Colorful0913/Bing/05、xx（仅供参考）/重要说明.jpg

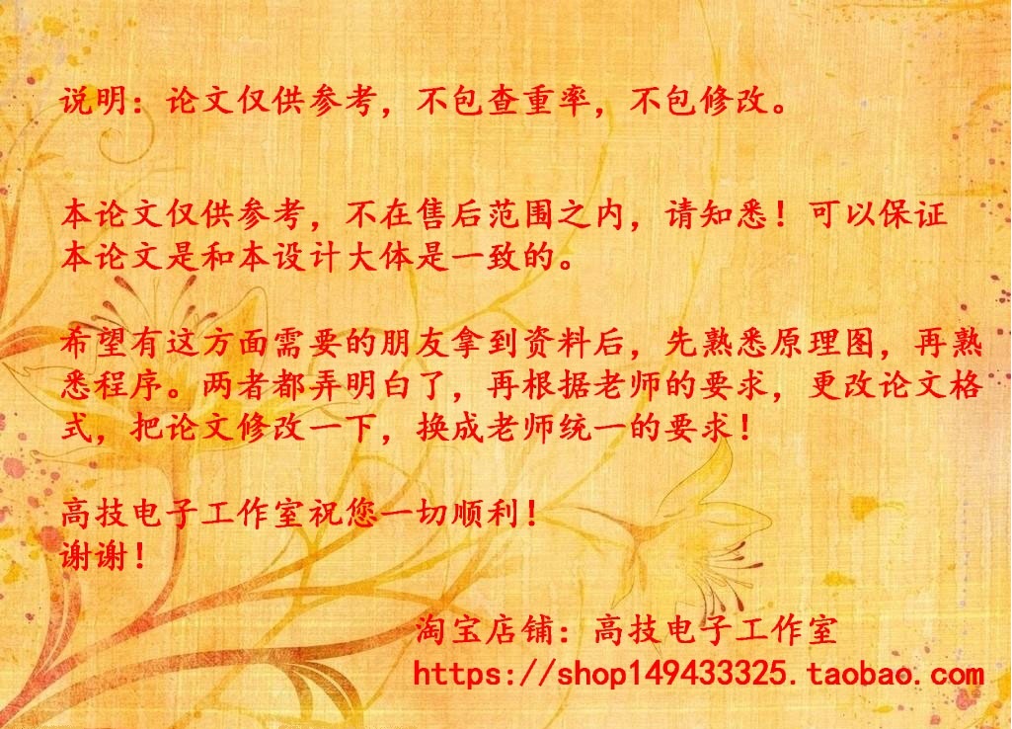
05、xx（仅供参考）/重要说明.jpg
