Colorful0913/Bing/15、软件--AltiumDesigner 安装包/下载链接.docx

AD21

链接：https://pan.baidu.com/s/1PjZRpn5fyLb_b4fBxMVxTA

提取码：bwog

内有安装步骤
