Colorful0913/Bing/16、软件--Keil 安装包/Keil4 for c51.docx

Keil4 for c51

链接：https://pan.baidu.com/s/1aW2NqCbxQEBSRBnlR4P-bA

提取码：244b

安装步骤：https://blog.csdn.net/weixin_45488504/article/details/126841689
