Colorful0913/Bing/17、软件--Proteus 安装包/Proteus软件.docx

任选其一：

Proteus8.13

链接：https://pan.baidu.com/s/1NiYXPCH6za3L4XKlXG91vw

提取码：8x27

Proteus8.3

链接：https://pan.baidu.com/s/18M6kN65PtYBDRmnJfNIrVw

提取码：h10p
