Colorful0913/Bing/09、数据手册/25、软件--Keil 安装包/Keil软件安装包与安装教程.docx

Keil软件安装包与安装教程下载链接与密码：

链接：http://pan.baidu.com/s/1pKXQDT5 密码：wyun

买设计，就到--高技电子工作室。授人以鱼，也要授之以渔！

https://shop149433325.taobao.com

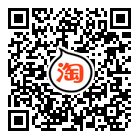
[picture p3: figure]
