Colorful0913/Bing/04、仿真图/1、打开仿真程序需要安装哪个软件.jpg

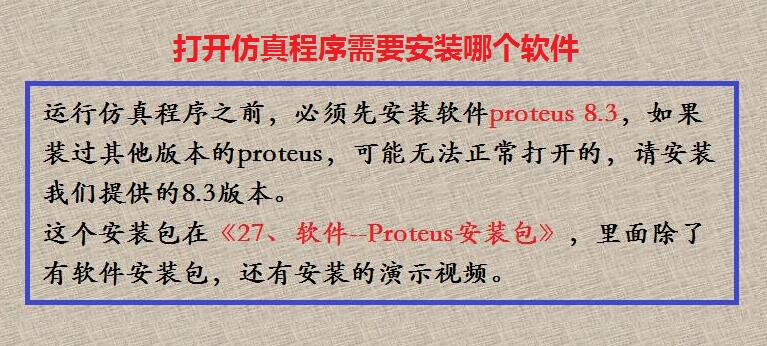
04、仿真图/1、打开仿真程序需要安装哪个软件.jpg
