Colorful0913/Bing/11、实物高清图片/4.jpg

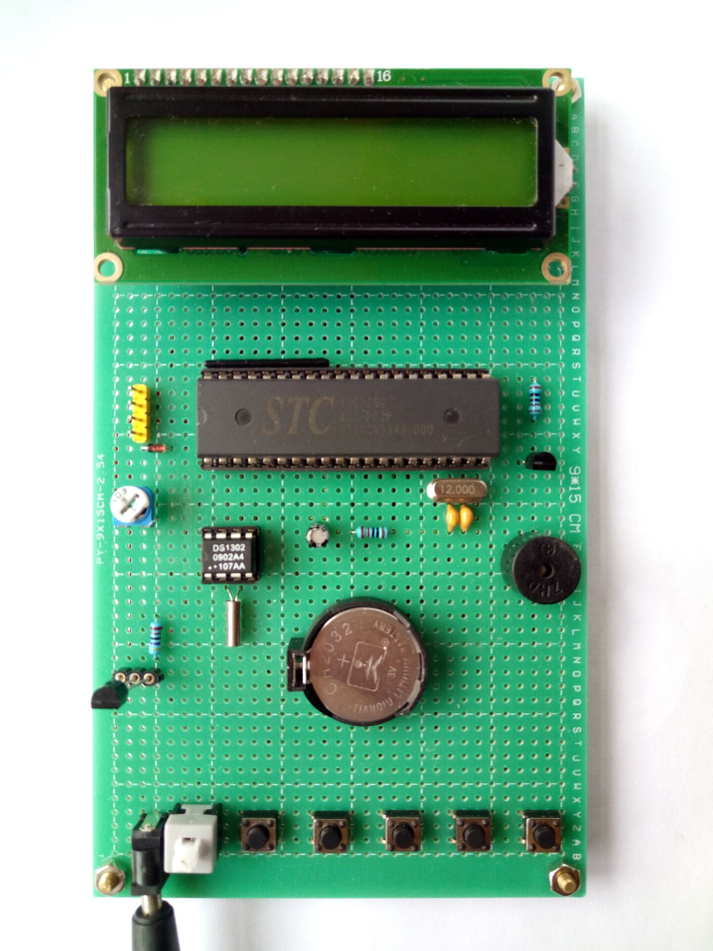
11、实物高清图片/4.jpg
