Colorful0913/Bing/12、焊接参考图片/5.jpg

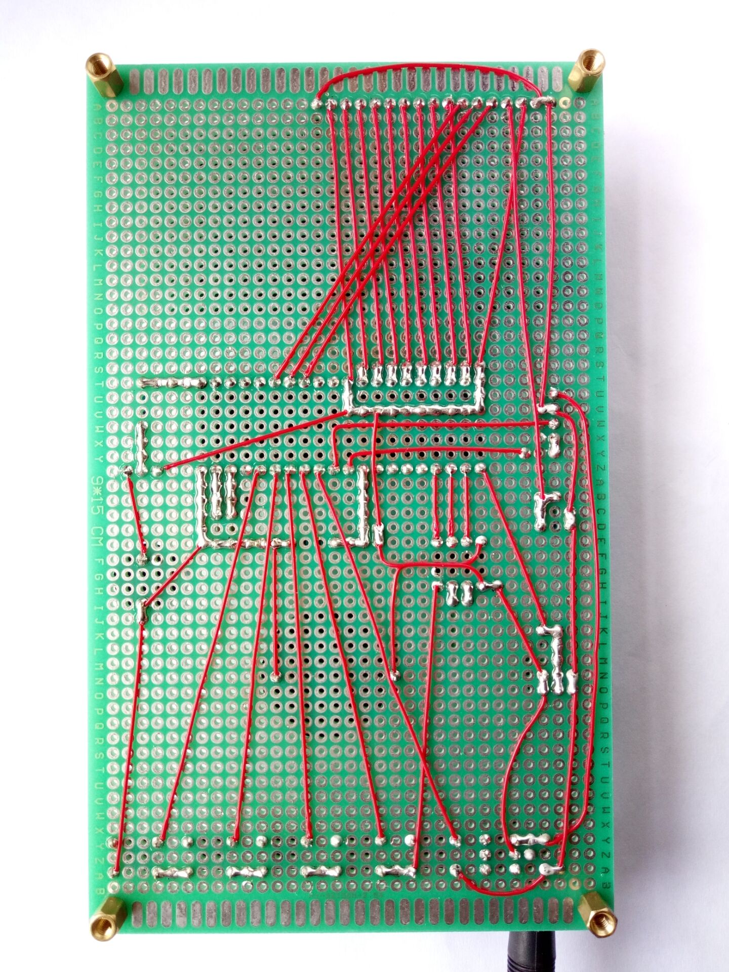
12、焊接参考图片/5.jpg
