Colorful0913/Bing/(list of files, cad)

Other CAD files:
03、单片机程序/02、程序（Keil版）/main.OBJ
