Colorful0913/Bing/02、电路图（原理图和PCB图）/02、PDF与Word格式/PCB.pdf

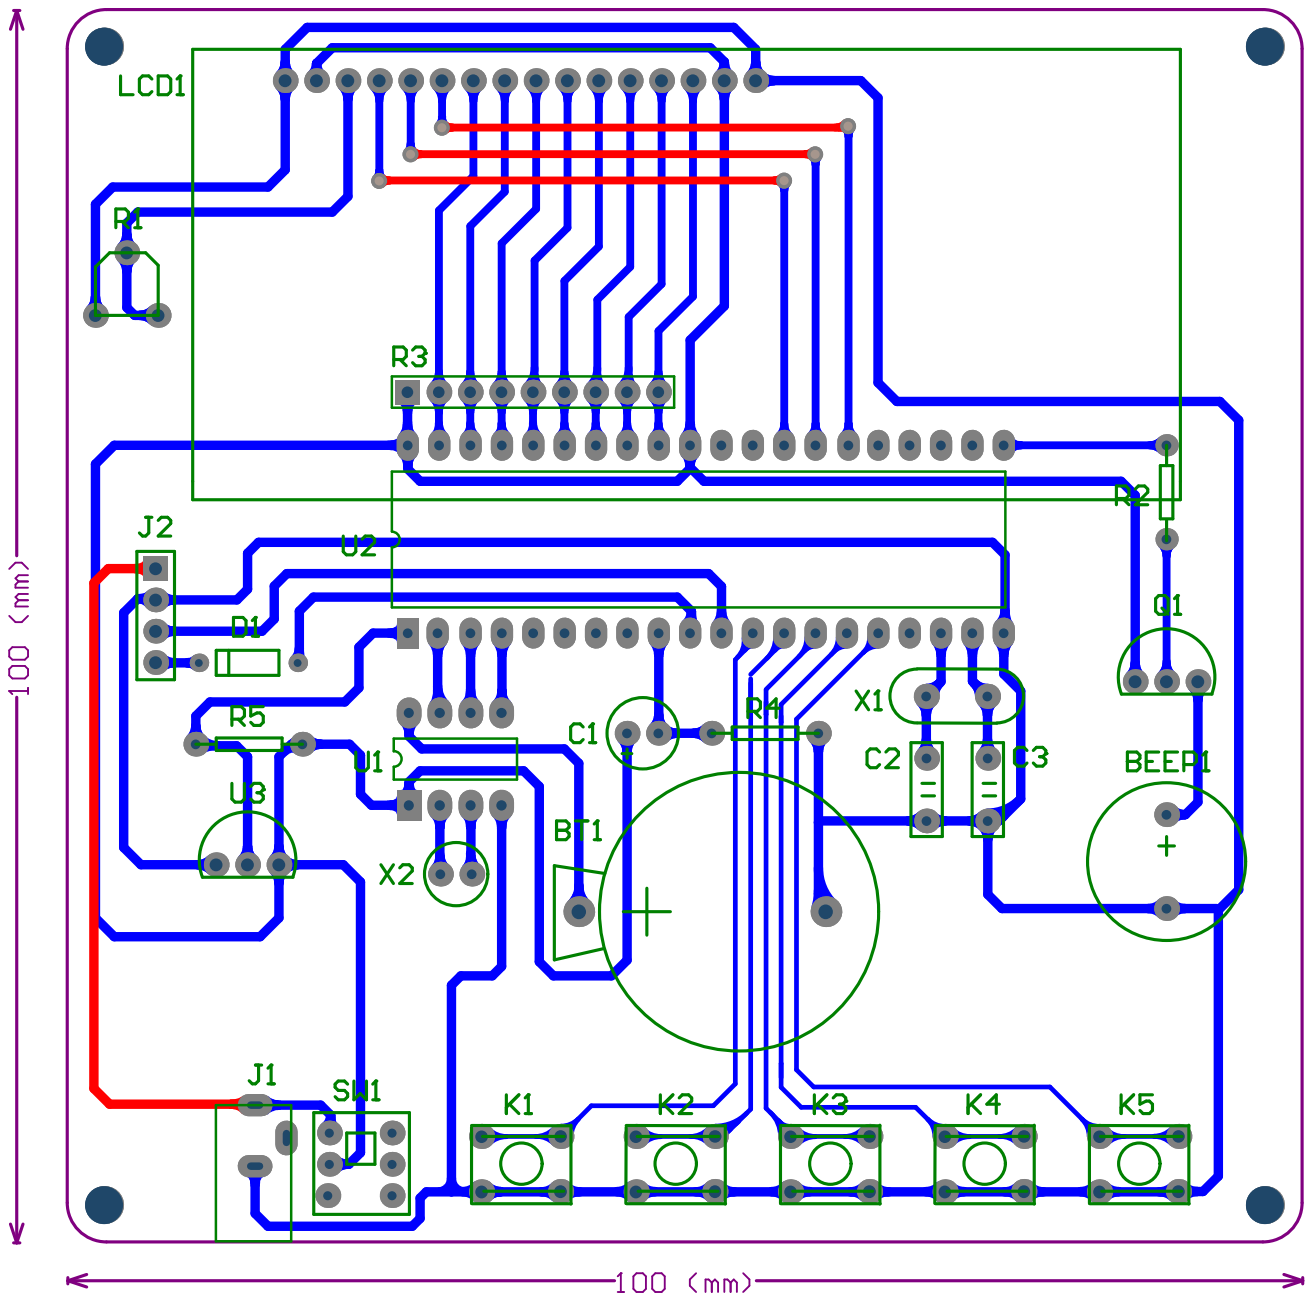
[picture p25: page 1]
