Colorful0913/Bing/02、电路图（原理图和PCB图）/02、PDF与Word格式/SCH.pdf

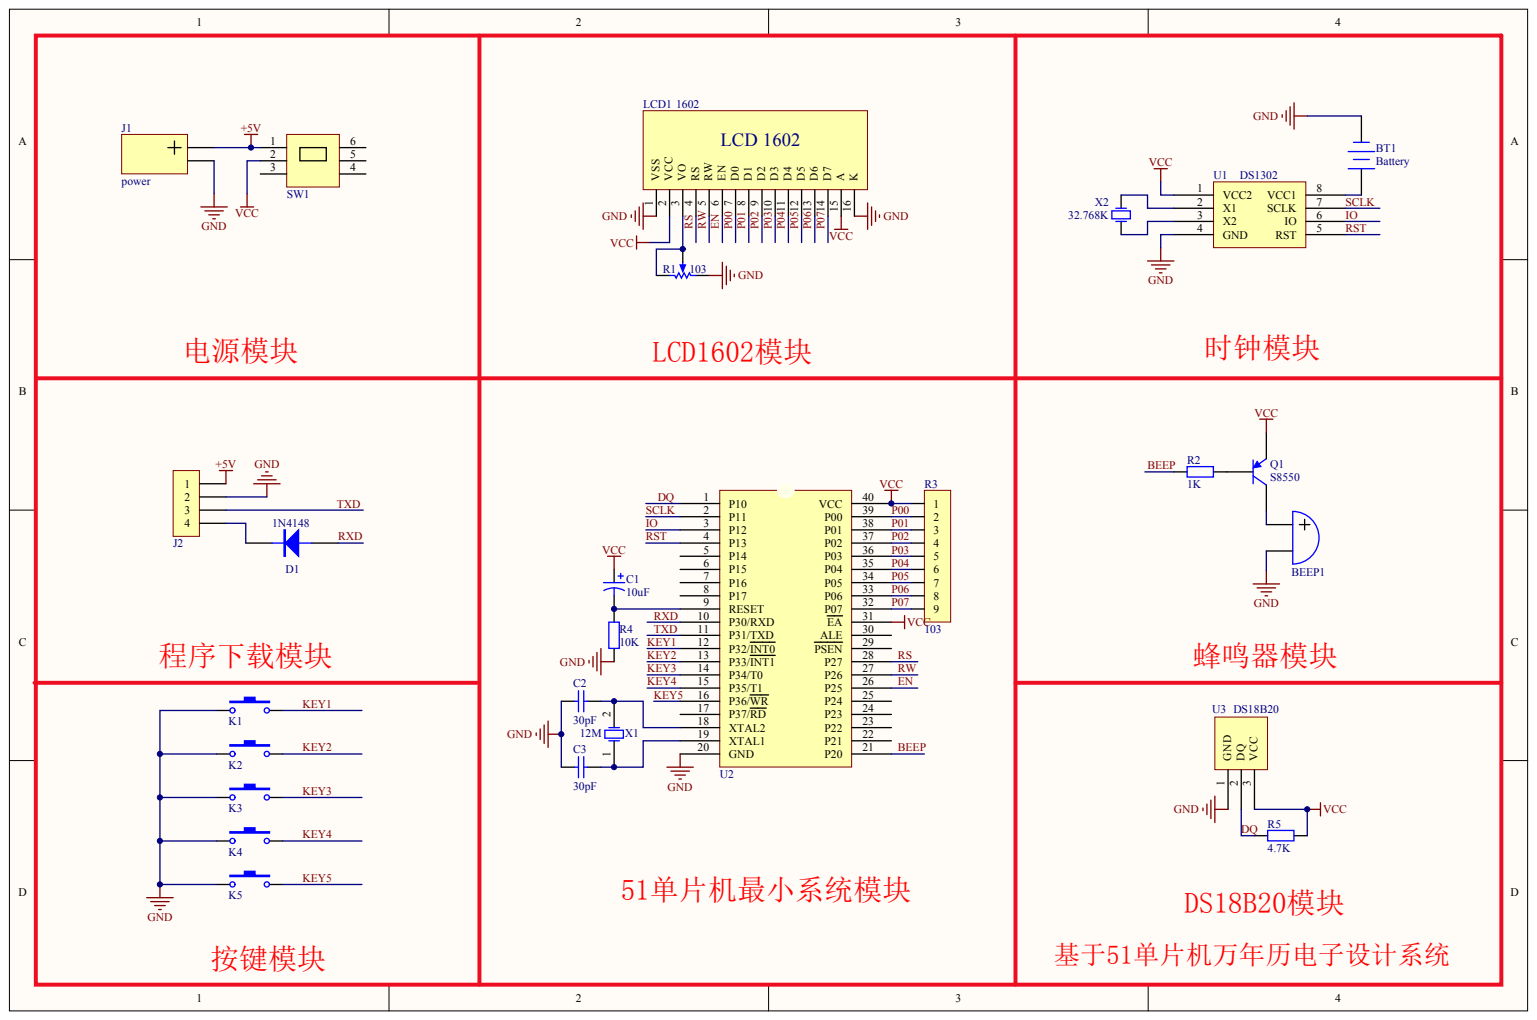
[picture p26: page 1]
