Colorful0913/Bing/(list of files, drawings)

Other design files:
02、电路图（原理图和PCB图）/01、Altium Designer格式/基于51单片机万年历电子设计系统.PcbDoc
02、电路图（原理图和PCB图）/01、Altium Designer格式/基于51单片机万年历电子设计系统.SchDoc
02、电路图（原理图和PCB图）/03、Protel 99SE格式/基于51单片机万年历电子设计系统.PcbDoc
02、电路图（原理图和PCB图）/03、Protel 99SE格式/基于51单片机万年历电子设计系统.SchDoc
04、仿真图/仿真图/project.pdsprj
